Suya1671/quiz-sys/button/models/TS-1088-AR02016--3DModel-STEP-269445.STEP

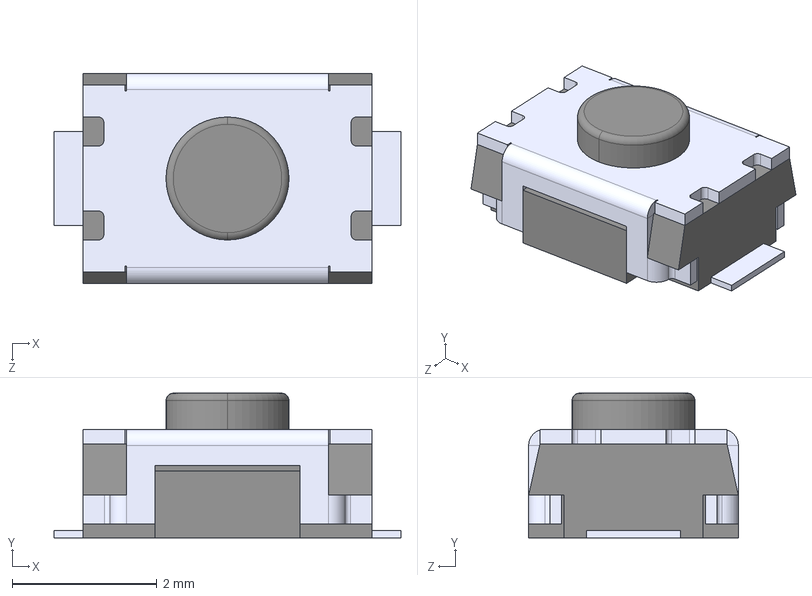
[picture p20: CAD file, 2025-07-04]
button/models/TS-1088-AR02016--3DModel-STEP-269445.STEP
4.80 x 2.00 x 2.90 mm
