Suya1671/quiz-sys/button/button.kicad_pcb

## KiCad design button/button.kicad_pcb (2025-07-04)

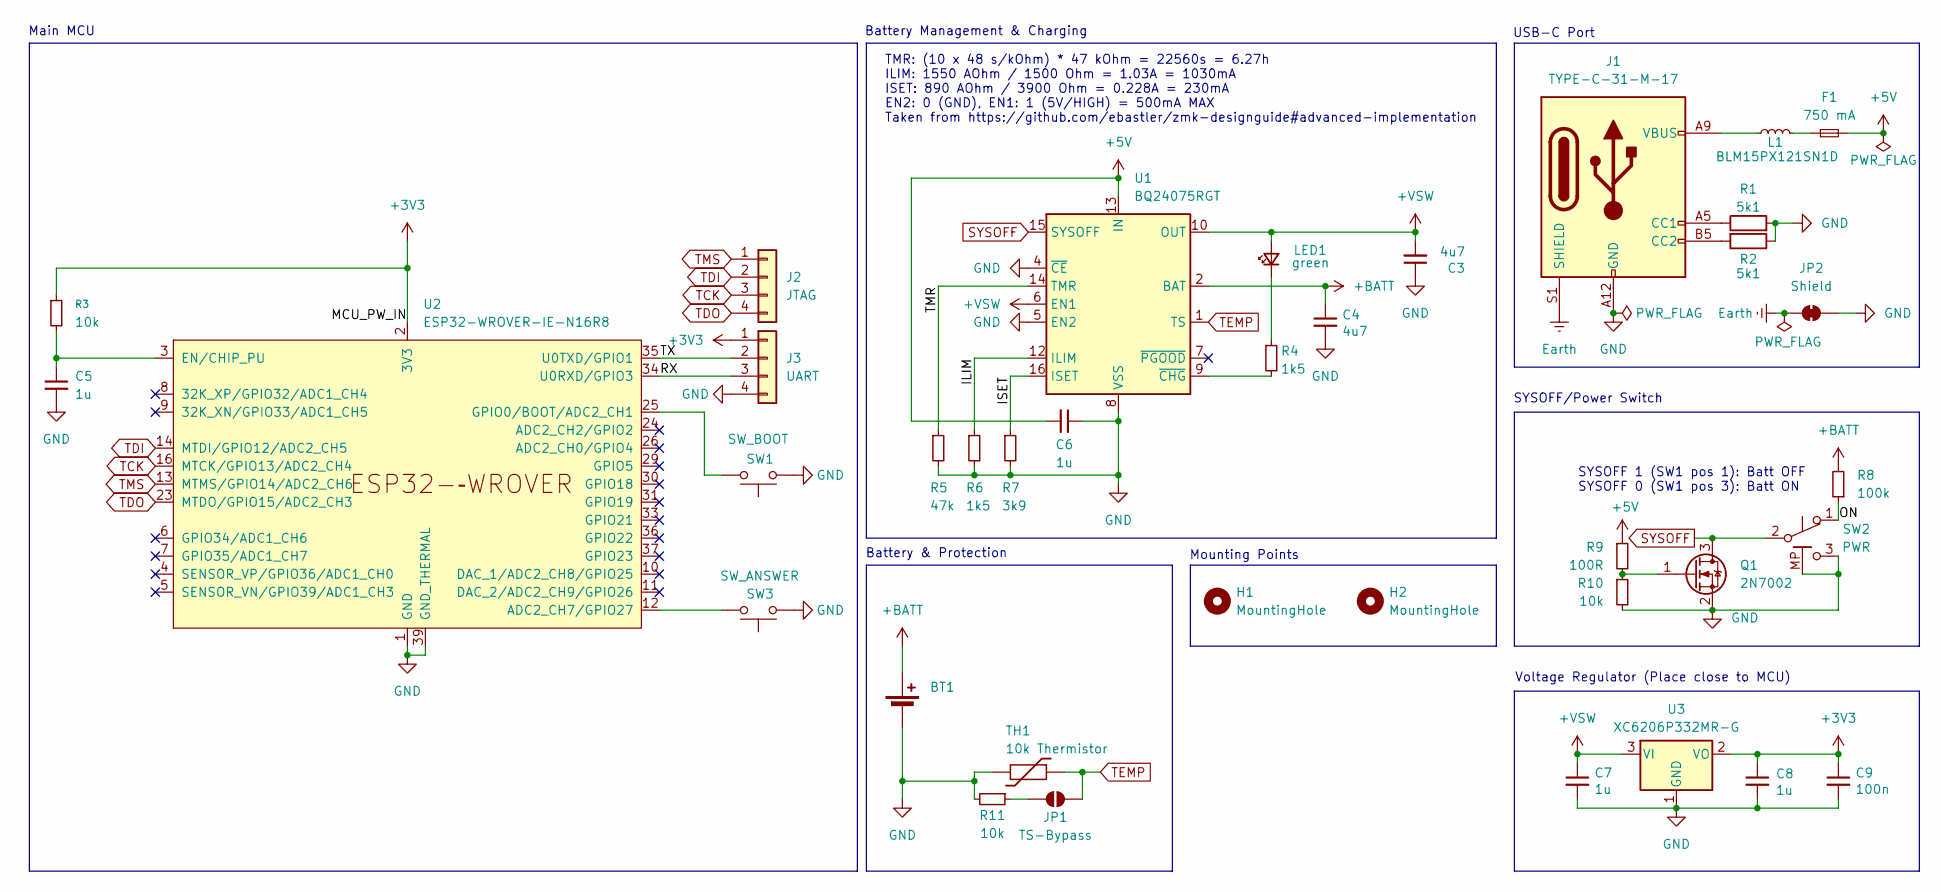
[picture p21: schematic button.kicad_sch]

Parts:
BT1: Battery_Cell; JST_PH_S2B-PH-K_1x02_P2.00mm_Horizontal
C3, C4: 4u7; C_0402_1005Metric_Pad0.74x0.62mm_HandSolder; LCSC C1538
C5, C6, C7, C8: 1u; C_0402_1005Metric_Pad0.74x0.62mm_HandSolder; LCSC C52923
C9: 100n; C_0402_1005Metric_Pad0.74x0.62mm_HandSolder; LCSC C1525
F1: 750 mA; Fuse_0603_1608Metric; LCSC C2687878
H1, H2: MountingHole; MountingHole_2.2mm_M2
J1: TYPE-C-31-M-17; USB_C_Receptacle_HRO_TYPE-C-31-M-17; LCSC C283540
J2: JTAG; PinHeader_1x04_P2.54mm_Horizontal; LCSC C91552
J3: UART; PinHeader_1x04_P2.54mm_Horizontal; LCSC C91552
JP1: TS-Bypass; SolderJumper-2_P1.3mm_Open_RoundedPad1.0x1.5mm
JP2: Shield; SolderJumper-2_P1.3mm_Bridged_RoundedPad1.0x1.5mm
L1: BLM15PX121SN1D; L_0402_1005Metric; LCSC C88970
LED1: green; LED_0603_1608Metric_Pad1.05x0.95mm_HandSolder; LCSC C2290
Q1: 2N7002; SOT-23; LCSC C8545
R1, R2: 5k1; R_0402_1005Metric_Pad0.72x0.64mm_HandSolder; LCSC C25905
R3, R10, R11: 10k; R_0402_1005Metric_Pad0.72x0.64mm_HandSolder; LCSC C25744
R4, R6: 1k5; R_0402_1005Metric_Pad0.72x0.64mm_HandSolder; LCSC C25867
R5: 47k; R_0402_1005Metric_Pad0.72x0.64mm_HandSolder; LCSC C25792
R7: 3k9; R_0603_1608Metric_Pad0.98x0.95mm_HandSolder; LCSC C23018
R8: 100k; R_0402_1005Metric_Pad0.72x0.64mm_HandSolder; LCSC C25741
R9: 100R; R_0402_1005Metric_Pad0.72x0.64mm_HandSolder; LCSC C25076
SW1: SW_BOOT; TS-1088-AR02016; LCSC C720477
SW2: PWR; SW_MSK12C02-HB; LCSC C431541
SW3: SW_ANSWER; WAGO 2060-452998-404; LCSC C2765055
TH1: 10k Thermistor; TestPoint_2Pads_Pitch5.08mm_Drill1.3mm
U1: BQ24075RGT; VQFN-16-1EP_3x3mm_P0.5mm_EP1.6x1.6mm; LCSC C15464
U2: ESP32-WROVER-IE-N16R8; ESP32-WROVER-E
U3: XC6206P332MR-G; SOT-23-3; LCSC C5446

Connections:
+3V3: C8.1, C9.1, J3.1, R3.1, U2.2 (3V3), U3.2 (VO)
+5V: C6.2, F1.2, R9.1, U1.13 (IN)
+BATT: BT1.1 (+), C4.1, R8.2, U1.2 (BAT), U1.3 (BAT)
+VSW: C3.2, C7.1, LED1.2 (A), U1.6 (EN1), U1.10 (OUT), U1.11 (OUT), U3.3 (VI)
/ILIM: R6.1, U1.12 (ILIM)
/ISET: R7.1, U1.16 (ISET)
/ON: R8.1, SW2.1 (A)
/RX: J3.3, U2.34 (U0RXD/GPIO3)
/TMR: R5.1, U1.14 (TMR)
/TX: J3.2, U2.35 (U0TXD/GPIO1)
Earth: J1.S1 (SHIELD), JP2.1 (A)
GND: BT1.2 (-), C3.1, C4.2, C5.2, C6.1, C7.2, C8.2, C9.2, J1.A12 (GND), J1.B12 (GND), J3.4, JP2.2 (B), Q1.2 (S), R1.2, R2.1, R5.2, R6.2, R7.2, R10.2, R11.2, SW1.1, SW2.3 (C), SW2.MP (Mounting), SW3.1, TH1.2, U1.4 (~CE), U1.5 (EN2), U1.8 (VSS), U1.17 (VSS), U2.1 (GND), U2.15 (GND), U2.38 (GND), U2.39 (GND_THERMAL), U3.1 (GND)
unnamed: F1.1, L1.2
unnamed: J1.A5 (CC1), R1.1
unnamed: J1.B5 (CC2), R2.2
unnamed: J1.A9 (VBUS), J1.B9 (VBUS), L1.1
unnamed: JP1.1 (A), R11.1
unnamed: LED1.1 (K), R4.1
unnamed: Q1.1 (G), R9.2, R10.1
unnamed: R4.2, U1.9 (~CHG)
unnamed: SW3.2, U2.12 (ADC2_CH7/GPIO27)
unnamed: C5.1, R3.2, U2.3 (EN/CHIP_PU)
unnamed: SW1.2, U2.25 (GPIO0/BOOT/ADC2_CH1)
SYSOFF: Q1.3 (D), SW2.2 (B), U1.15 (SYSOFF)
TCK: J2.3, U2.16 (MTCK/GPIO13/ADC2_CH4)
TDI: J2.2, U2.14 (MTDI/GPIO12/ADC2_CH5)
TDO: J2.4, U2.23 (MTDO/GPIO15/ADC2_CH3)
TEMP: JP1.2 (B), TH1.1, U1.1 (TS)
TMS: J2.1, U2.13 (MTMS/GPIO14/ADC2_CH6)

Notes on the sheet:
Mounting Points
USB-C Port
TMR: (10 x 48 s/kOhm) * 47 kOhm = 22560s = 6.27h ILIM: 1550 AOhm / 1500 Ohm = 1.03A = 1030mA ISET: 890 AOhm / 3900 Ohm = 0.228A = 230mA EN2: 0 (GND), EN1: 1 (5V/HIGH) = 500mA MAX Taken from https://github.com/ebastler/zmk-designguide#advanced-implementation
Battery Management & Charging
SYSOFF/Power Switch
Voltage Regulator (Place close to MCU)
Main MCU
SYSOFF 1 (SW1 pos 1): Batt OFF SYSOFF 0 (SW1 pos 3): Batt ON
Battery & Protection

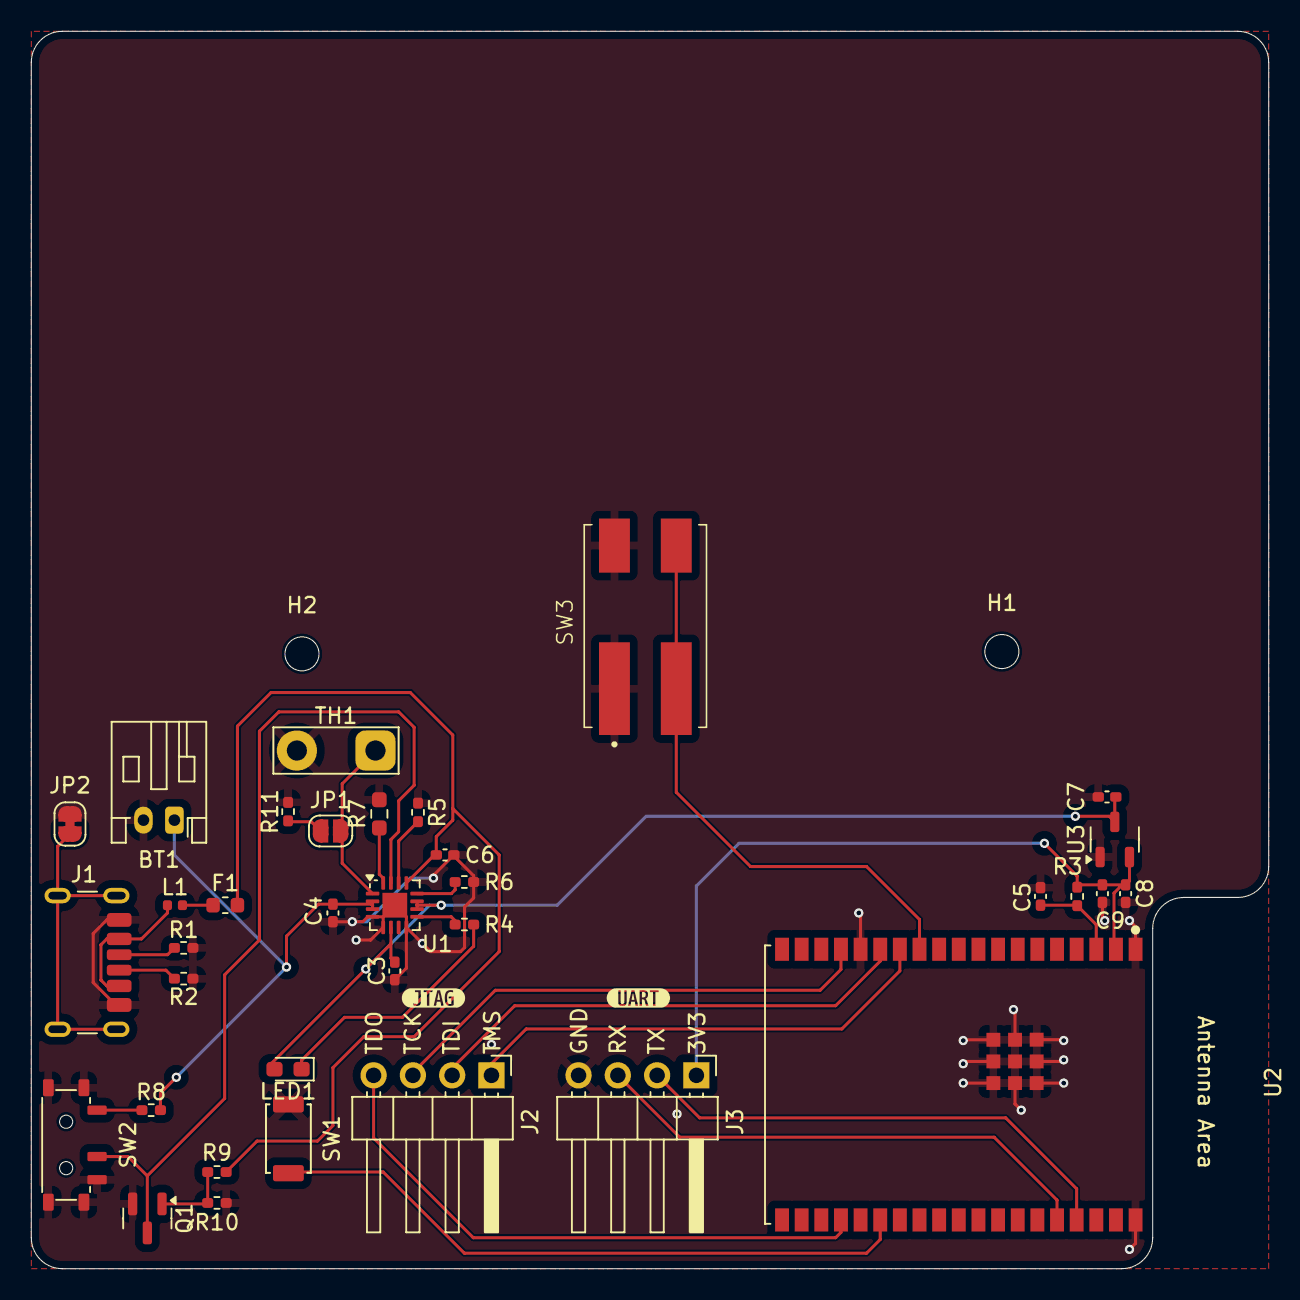
[picture p22: board button.kicad_pcb from above]

Board: 2 copper layers, 80.0 x 80.0 mm, 39 parts (0 on the bottom side), 29 nets.

Other parts of the board:
kibuzzard-685930AE: G***; kibuzzard-685930AE
kibuzzard-6859309F: G***; kibuzzard-6859309F
